Agwld/gps-firmware/gps-mainboard.pdf

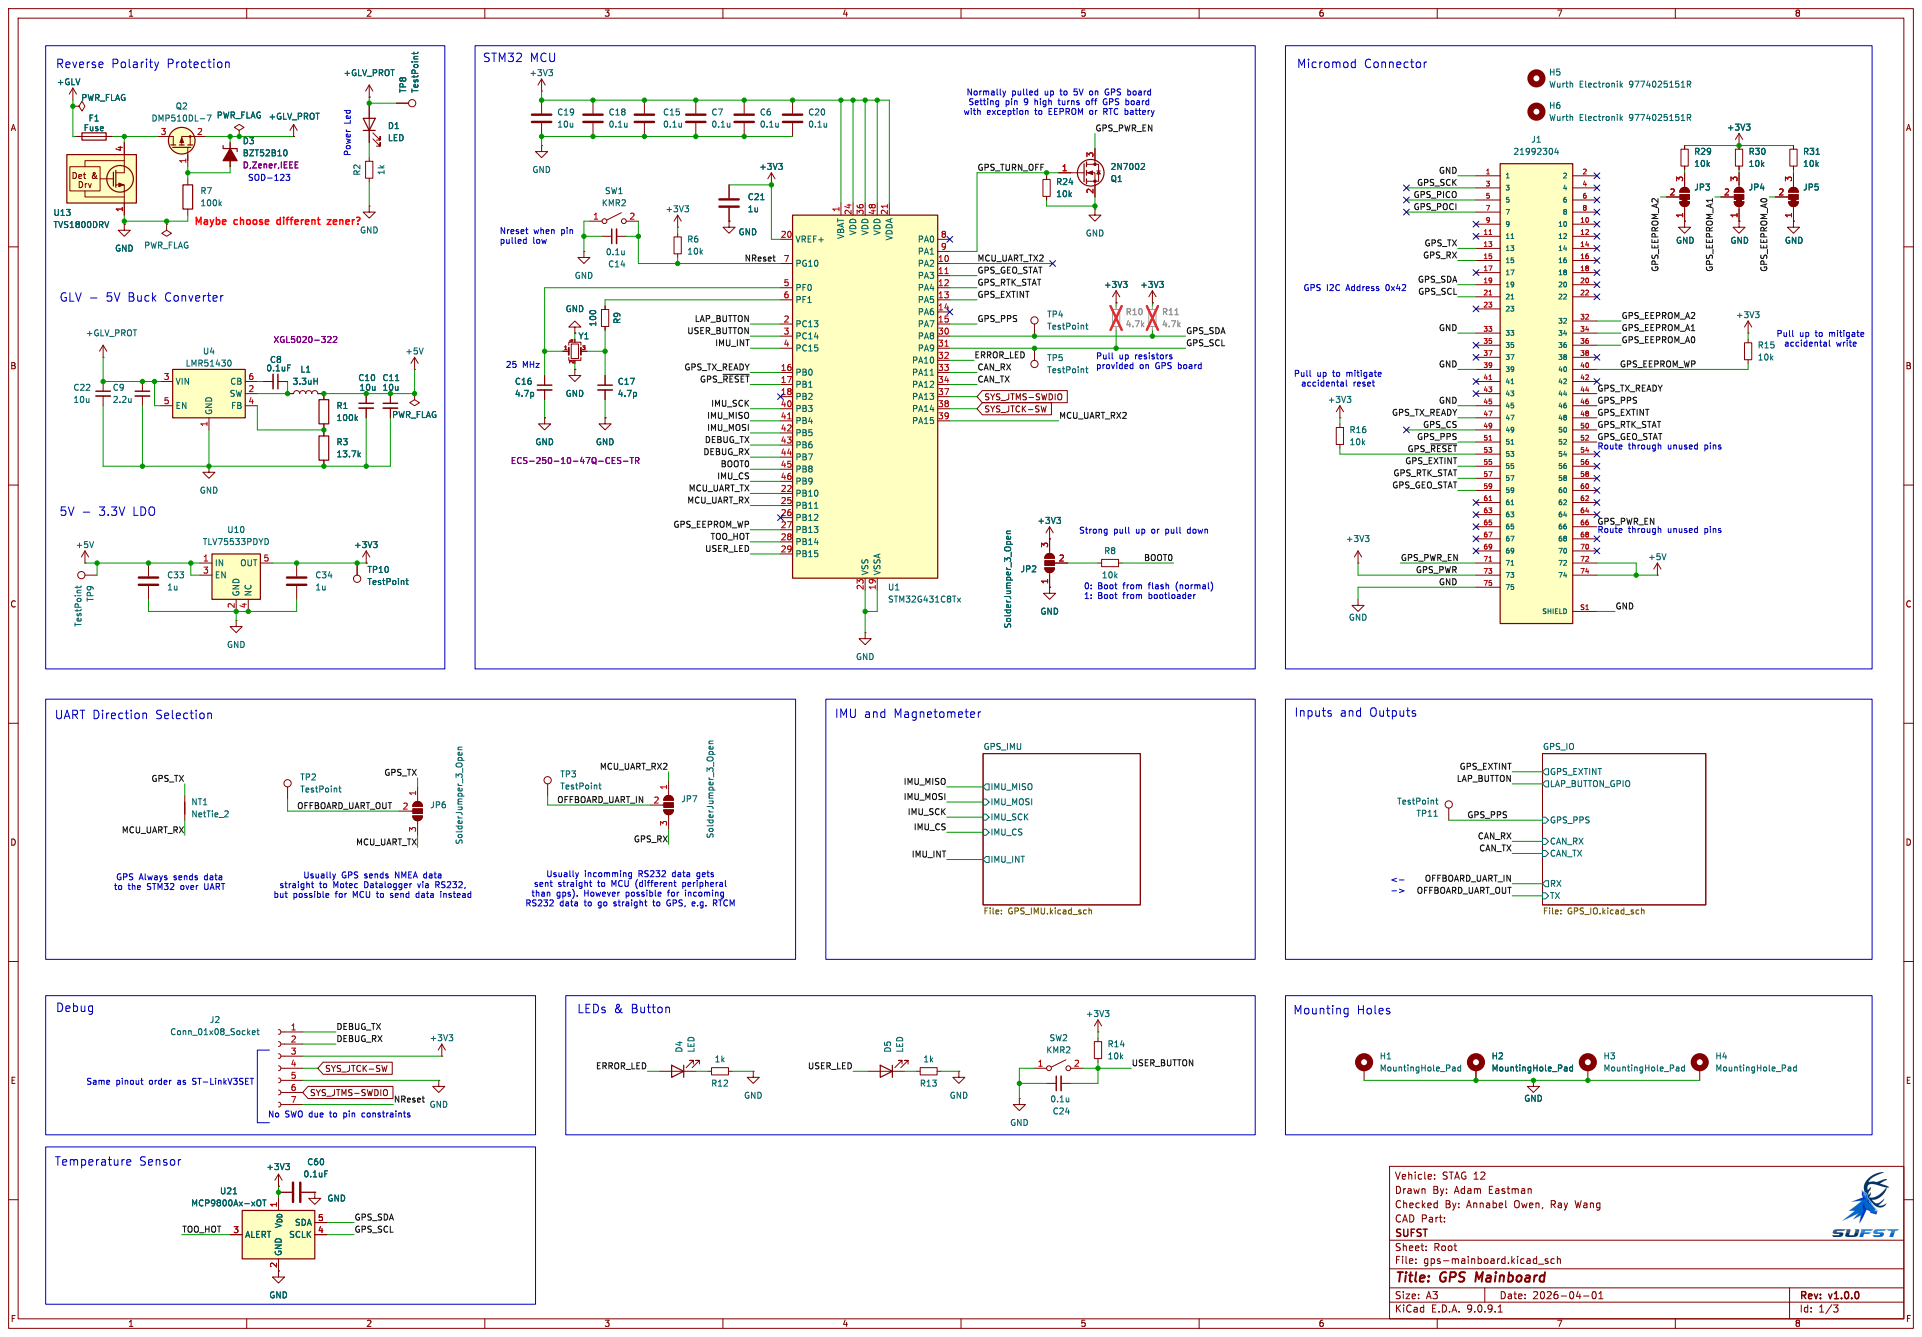
[picture p1: page 1]

Pull up resistors provided on GPS board Reverse Polarity Protection

JP3 GND
10k NT1 NetTie_2
0: Boot from flash (normal) 1: Boot from bootloader Maybe choose different zener?

1 VDD 24 VDD 36 VSS 23 VDD 48 VSSA 19 VDDA 21 PA0 8 PA1 9 PA2 10 PA3 11 PA4 12 PA5 13 PA6 14 PA7 15 PA8 30 PA9 31 PA10 32 PA11 33 PA12 34 PA13 37 PA14 38 PA15 39 U1STM32G431C8Tx

Pull up to mitigate

3Y1 ECS-250-10-47Q-CES-TR GND

1k TP3 TestPoint SDA 5 SCLK 4 V_{DD} 1 GND

GPS Always sends data
to the STM32 over UART

Usually GPS sends NMEA data

-> No SWO due to pin constraints

Same pinout order as ST-LinkV3SET

Id: 1/3 Title: GPS Mainboard

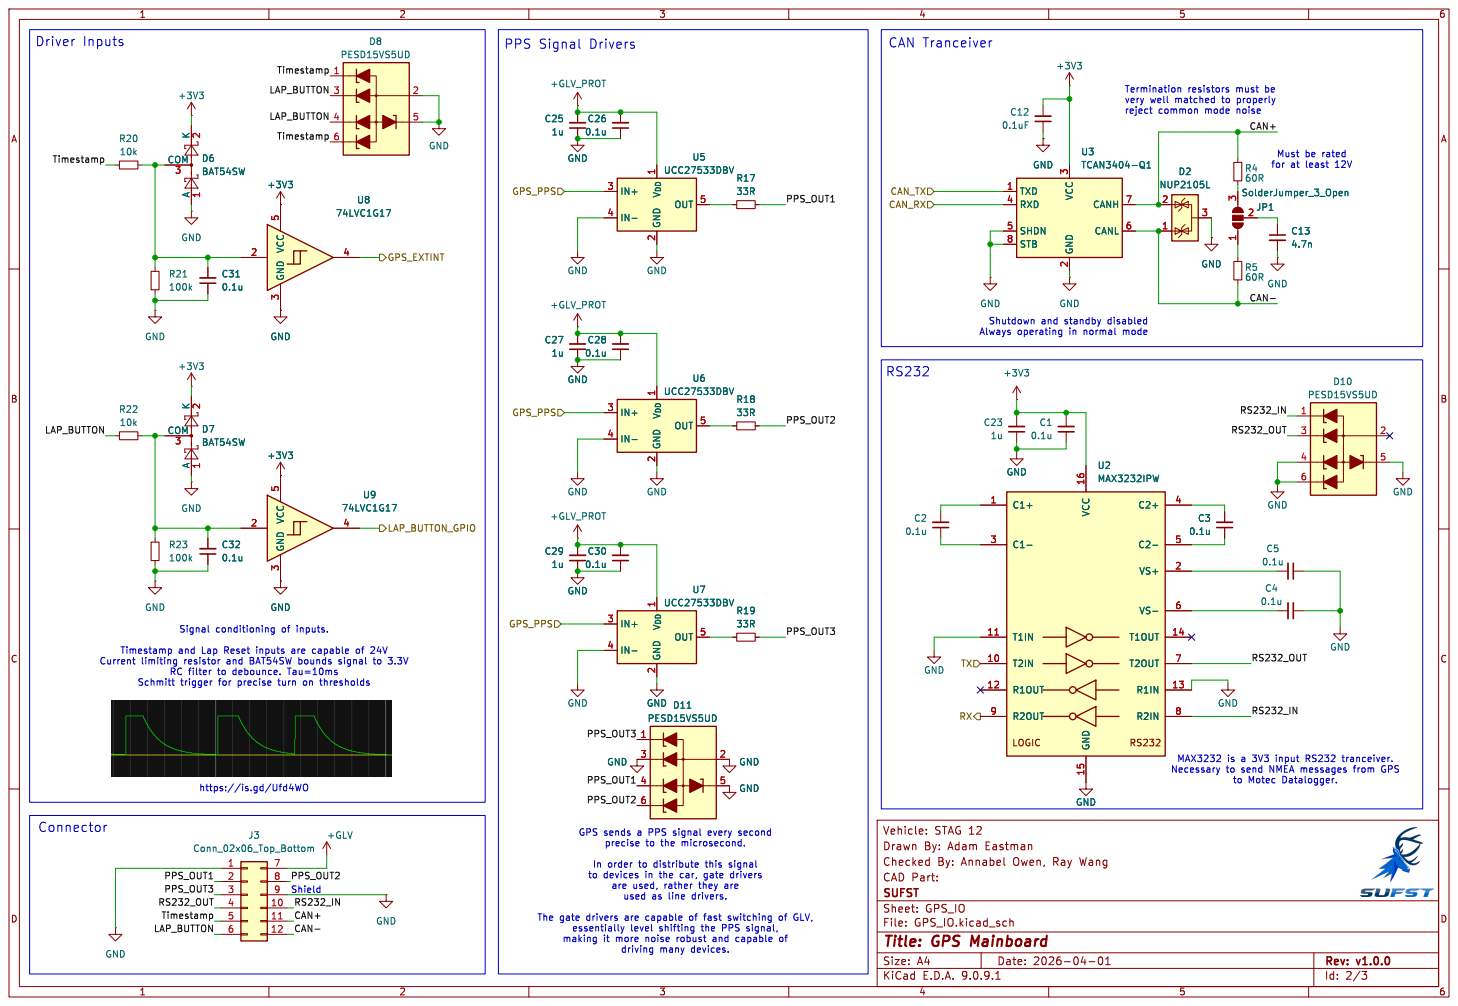
[picture p2: page 2]

reject common mode noise Driver Inputs

for at least 12V MAX3232 is a 3V3 input RS232 tranceiver. Necessary to send NMEA messages from GPS

very well matched to properly

2 CANH 7 CANL 6 U3 TCAN3404-Q1 GND GND GND

2 CANH 7 CANL 6 GND GND

making it more noise robust and capable of driving many devices. Connector

GPS sends a PPS signal every second
precise to the microsecond.

File: GPS_IO.kicad_sch Sheet: GPS_IO
Id: 2/3 Title: GPS Mainboard

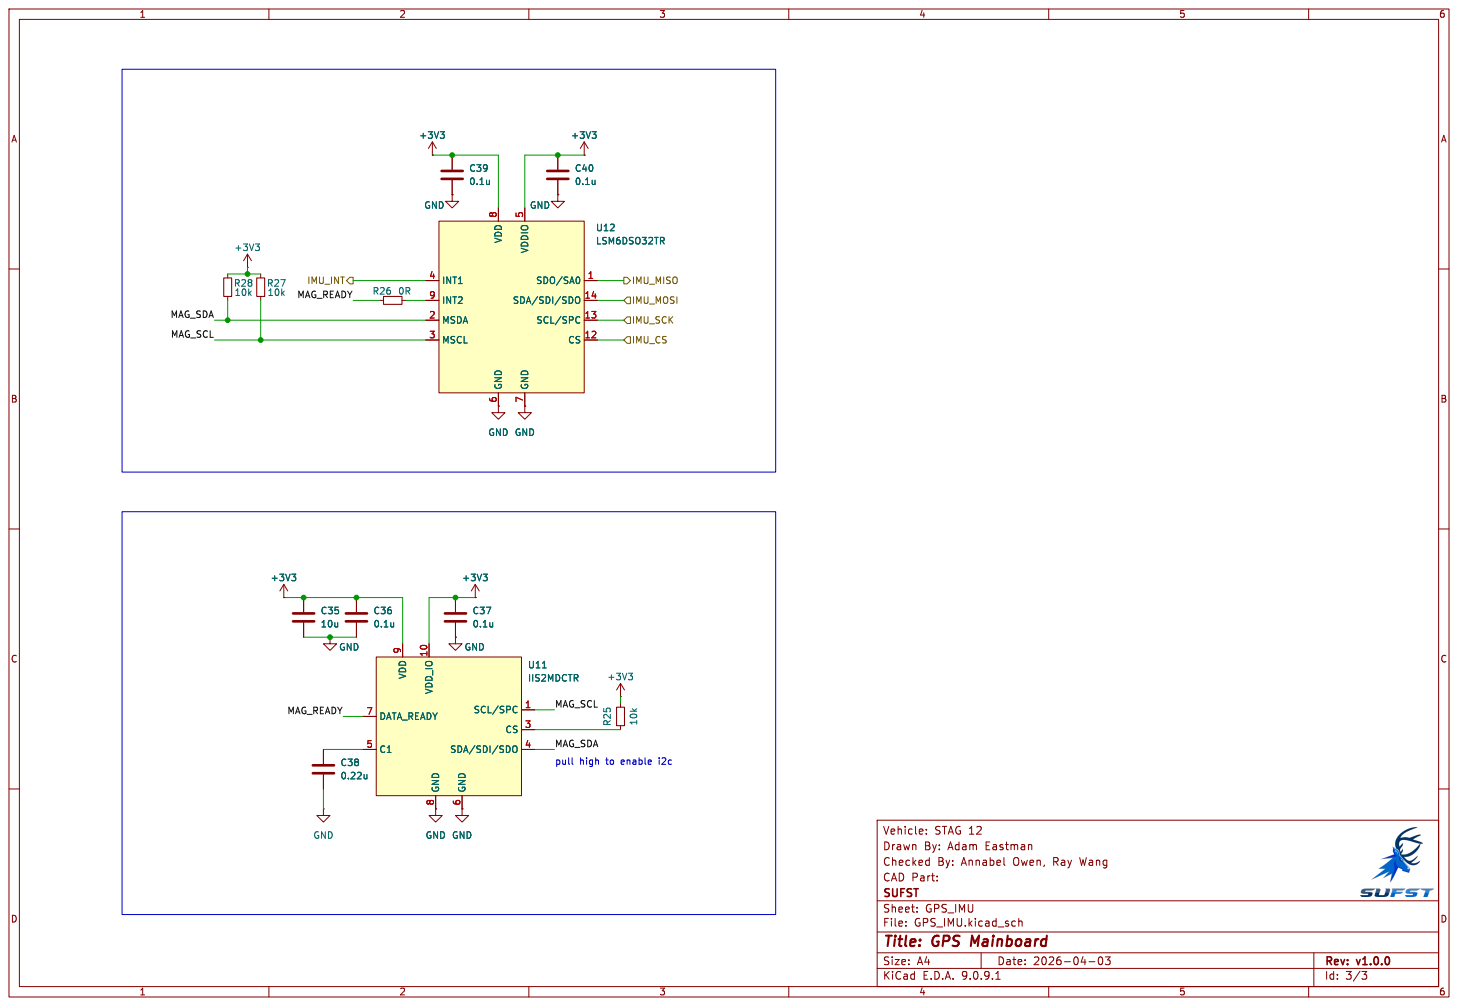
[picture p3: page 3]

7 SDO/SA0 1 SDA/SDI/SDO 14 SCL/SPC 13 CS 12U12

7 SDO/SA0 1 SDA/SDI/SDO 14 SCL/SPC 13 CS 12 GND GND

6 SCL/SPC 1 CS 3 SDA/SDI/SDO 4U11

6 SCL/SPC 1 CS 3 SDA/SDI/SDO 4

pull high to enable i2c

File: GPS_IMU.kicad_sch Sheet: GPS_IMU
Id: 3/3 Title: GPS Mainboard
