Agwld/gps-firmware/Core/Src/spi.c

/**
 * @file    spi.c
 * @brief   SPI1 init for the LSM6DSO32 (mode 3, ~5.3 MHz).
 */

#include "main.h"

SPI_HandleTypeDef hspi1;

void MX_SPI1_Init(void)
{
    hspi1.Instance = SPI1;
    hspi1.Init.Mode = SPI_MODE_MASTER;
    hspi1.Init.Direction = SPI_DIRECTION_2LINES;
    hspi1.Init.DataSize = SPI_DATASIZE_8BIT;
    hspi1.Init.CLKPolarity = SPI_POLARITY_HIGH; /* mode 3 */
    hspi1.Init.CLKPhase = SPI_PHASE_2EDGE;
    hspi1.Init.NSS = SPI_NSS_SOFT;
    /* PCLK2 170 MHz / 32 = 5.3 MHz (LSM6DSO32 max SPI clock is 10 MHz) */
    hspi1.Init.BaudRatePrescaler = SPI_BAUDRATEPRESCALER_32;
    hspi1.Init.FirstBit = SPI_FIRSTBIT_MSB;
    hspi1.Init.TIMode = SPI_TIMODE_DISABLE;
    hspi1.Init.CRCCalculation = SPI_CRCCALCULATION_DISABLE;
    hspi1.Init.CRCPolynomial = 7U;
    hspi1.Init.CRCLength = SPI_CRC_LENGTH_DATASIZE;
    hspi1.Init.NSSPMode = SPI_NSS_PULSE_DISABLE;

    if (HAL_SPI_Init(&hspi1) != HAL_OK) {
        Error_Handler();
    }
}
