Agwld/gps-firmware/SUFST/Inc/sys/sys_task.h

/**
 * @file    sys_task.h
 * @brief   Entry point for sys_task (see app.c for creation).
 */

#ifndef SYS_TASK_H
#define SYS_TASK_H

#ifdef __cplusplus
extern "C" {
#endif

void sys_task_main(void *argument);

#ifdef __cplusplus
}
#endif

#endif /* SYS_TASK_H */
