Agwld/gps-firmware/(commit log)

2026-07-05 fix Wheel_Speeds byte-to-wheel labeling against sufst/can-defs DBC
    The DBC's little-endian start bits put WHEEL_RL_SPEED at byte 0 and
    WHEEL_FR_SPEED at byte 6, but canbc_task.c had the fr/fl/rr/rl
    variables reading those byte offsets in the opposite order. Harmless
    today since the code only sums all four for a symmetric average, but
    would have picked the wrong wheel pair once the planned
    least-slip-prone-pair refinement lands.
    [canbc_task.c]
2026-07-05 add PyQt6 GPS dashboard tool for CAN telemetry visualisation
    Decodes the GPS node's CAN traffic against tools/GPS.dbc: fix/position/
    attitude status, rolling speed/attitude/accel/gyro plots, and a 2D
    track map. Supports live SocketCAN/Vector/Kvaser interfaces, replay of
    candump-format logs, and a synthetic simulate mode, all through the
    same decode/UI pipeline. Also ignores the venv/cache dirs uv and
    pytest generate under tools/dashboard/.
    [base.py, live.py]
2026-07-05 wire up real CPU load reporting via FreeRTOS run-time stats
    GPS_Status.cpu_load_pct was a hardcoded zero because
    configGENERATE_RUN_TIME_STATS was never enabled. Rather than dedicate
    a spare timer to it, reuse the microsecond tick TIM3 already
    free-runs for GPS PPS timing (fusion/timebase.c) as the run-time-stats
    clock - its ~71 min software-extended wrap period comfortably outlasts
    a race session. sys_task.c now reports 100 -
    ulTaskGetIdleRunTimePercent() each cycle.
2026-07-05 convert IMU SPI reads to DMA, yielding the CPU during transfers
    lsm6dso32.c's register reads were blocking HAL_SPI_Transmit/Receive
    calls that spun the imu_task for the ~23us each burst takes. Switch
    read_regs() to a single full-duplex HAL_SPI_TransmitReceive_DMA on the
    SPI1 RX/TX DMA channels (already wired in the MSP but unused) and have
    the caller block on a completion semaphore instead, freeing the CPU
    for other tasks while the transfer runs.
    - Completion/error are signalled from HAL_SPI_TxRxCplt/ErrorCallback,
    which raise CS and give the semaphore; a new SPI1_IRQHandler routes
    bus errors so a fault is reported promptly rather than only via the
    caller's timeout.
    - On timeout, abor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
    [imu_task.c, lsm6dso32.c]
2026-07-05 persist gates as absolute lat/lon; broadcast origin+gates for the dash
    Gate persistence was effectively dead: flash_store_save_gate() was never
    called, and gates were stored as ENU relative to a per-boot origin, so
    they could never reproduce across a power cycle anyway. Rework it so the
    car can be switched off, moved, and switched on with the start/finish
    and sectors returning to the right physical places:
    - flash_store now stores gates as absolute lat/lon (i32 1e-7 deg, not a
    float32 degree which only carries ~1 m). Restore no longer calls
    gates_set (the ENU origin isn't known at boot) - it fills a RAM table
    that imu_task resolves to ENU once the first fix anchors the frame.
    - Both s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
    [can_defs.h, can_pack.c, canbc.c, canbc_task.c, flash_store.c, imu_task.c]
2026-07-05 dashboard: draw gates/origin, remember track shapes, complex sim track
    - track_map renders the broadcast map: start/finish (green) and sector
    (yellow) gate lines lifted from GPS_Gate's ENU through GPS_Frame_Origin
    back to absolute lat/lon, then projected into the widget's frame so
    they line up with the trail regardless of which origin each side picked.
    - track_memory: remembers each track's outline locally, keyed by a
    fingerprint of the (now reproducible) gate layout. On startup the
    matching track's shape reloads as a faint reference so it isn't blank
    until the first lap; saved on close. This is the recommended split -
    the node owns the small, reproducible gates; the dash owns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
2026-07-05 sim: start/finish on a straight + realistic corner/straight speed profile
    Two realism fixes to the simulated circuit:
    - Reshaped the track so the start/finish sits on a genuine main straight
    (three collinear waypoints keep it dead straight) instead of on the
    tight return it landed on before - no more hairpin across the line.
    - Replaced the constant-speed march with a curvature-derived speed
    profile: grip-limited corner speeds (sqrt(a_lat/kappa)) with
    forward/backward accel+brake passes so the car brakes into and powers
    out of corners, then time-scaled so a lap still takes lap_period_s.
    Longitudinal g (GPS_IMU_Accel ax) now reflects that braking/accel too.
    On the default track s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
    [simulate.py]
2026-07-05 dashboard: remote gate control + working lap timing
    Two gaps the receive-only dashboard had:
    - Remote control: added a TX path (CanSource.send, LiveCanSource.send via
    python-can, IngestWorker.send) and a Gate control panel that mirrors
    the steering-wheel lap button - Set start/finish, Set next sector
    (auto-incrementing slot), Clear all, Save to flash - sending
    GPS_Command frames. Live mode puts them on the real bus; simulate mode
    drives the simulated node.
    - Lap timing: the simulator now runs a real gate-crossing timer instead
    of faking it - it accepts GPS_Command (dynamic 8-slot gate table),
    detects crossings in arc-length space, and emits Lap_Event (lap +
    sector) with a p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
2026-07-05 docs: comprehensive product documentation suite
    Add professional documentation covering all aspects of the GPS node:
    - README.md: Clean product-focused overview (gates, timing, status)
    - QUICK_START.md: 5-minute build guide for engineers
    - DEVELOPER.md: Full development guide (build, test, debug, CI, conventions)
    - DRIVER_GUIDE.md: User guide for drivers (button FSM, troubleshooting)
    - ARCHITECTURE.md: Technical deep dive (fusion, timing, CAN, persistence)
    - DATASHEET.md: Complete hardware & firmware specs (pinouts, memory, matrix)
    - NOTES.md: Design rationale, limitations, future enhancements
    Documentation structured for multiple audiences: drivers, developers, maintainers.
    Co-Authored-B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
2026-07-05 Update PCB size from 2 layers to 4 layers
2026-07-05 Update DATASHEET.md by removing specifications
    Removed mounting and form factor specifications from the datasheet.
2026-07-05 Remove board dimensions and connectors section
    Removed hardware specifications section from DATASHEET.md.
2026-07-05 canbus: broadcast GPS time on 0x6BD for other nodes
    New 1 Hz GPS_Time message: iTOW (same time domain as Lap_Event TM2
    marks, so other boards can timestamp their data consistently) plus UTC
    hour/min/sec for a human clock, with NAV-PVT validity flags. UTC date
    is deliberately not carried - it doesn't fit alongside full-precision
    iTOW in 8 bytes, and the MoTeC already gets it via NMEA RMC.
    Published from gps_task on every NAV-PVT (even before a position fix -
    time can resolve from fewer satellites, and the flags say how much to
    trust it). Dashboard status panel shows the UTC clock + iTOW readouts.
    [can_defs.h, can_pack.c, canbc.c, canbc_task.c, gps_task.c, test_can_pack.c]
2026-07-05 gps: configure the F9P over I2C - the board has no MCU->GPS UART path
    Verifying the firmware against the gps-mainboard schematic's UART
    direction jumpers showed three routing mismatches:
    - gps_config sent UBX-CFG-VALSET out USART3 TX, but PB10 only reaches
    the RS232 output via JP6; the F9P's UART1 RX is only fed from the
    RS232 input via JP7. Config could never arrive: the GPS would stay at
    its 38400/NMEA power-on defaults and the node would boot straight
    into GPS_FAULT on real hardware.
    - NMEA to the MoTeC went out USART2 TX (PA2), which is unrouted on the
    board.
    - The RTCM bridge forwarded USART2 RX to USART3 TX, which now feeds the
    MoTeC, not the GPS.
    New arrangement (jumpers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
2026-07-06 docs: fix aux_task role in DEVELOPER task table
    Straggler from af3be50: aux_task no longer forwards RTCM (that path is
    now RS232-in -> F9P UART1 in hardware via JP7, never touching the MCU).
    It only synthesises NMEA to the MoTeC on USART3 TX.
2026-07-06 imu: place gates stationary + continuous self-calibrating magnetometer
    Two related heading changes so gates/start-line can be set from a
    standstill, not only while driving.
    Gate placement: the gate line was always oriented from course-over-
    ground (the velocity vector), which is noise at rest - so a stationary
    set produced a randomly-rotated gate. Now hybrid: course when moving
    (>= LAP_GATE_COURSE_MIN_SPEED_MPS, mag-independent), else the AHRS yaw,
    which is valid stationary. Park nose-down-track, set, done.
    Magnetometer calibration: replaced the manual CAN-triggered min/max pass
    with continuous background calibration (mag_cal_cont_*). Every sample
    feeds a rolling window that tracks heading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
    [board_config.h, imu_task.c, mag_cal.c, test_mag_cal.c]
2026-07-06 build: require STM32G431CB, drop the C8 variant
    The board is built around the CB (128 KB flash); the smaller C8 (64 KB)
    was only ever kept selectable for interchangeability testing and Debug
    builds never fit it. Remove the whole variant machinery: delete
    STM32G431X8_FLASH.ld and the GPS_MCU_VARIANT switch, hardcode the CB
    linker script + GPS_FLASH_TOTAL_KB=128 (still the single source the
    flash-store reserved page derives from, so it can't drift from the
    linker script). Docs now state CB as a requirement.
    Also corrected the gate-store address in DATASHEET (0x1FC00 -> the
    actual 0x0801F800: last 2 KB page of 128 KB), which disagreed with
    ARCHITECTURE.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
    [flash_store.c]
2026-07-08 fix: resolve whole-project code review findings
    Fifteen correctness/robustness fixes from a full-codebase review, outside
    the continuous-mag-cal change.
    GPS / UBX:
    - gps_task: reduce the DMA ring write index modulo the ring size - a
    512-byte buffer wrap reports Size==512, which spun the drain loop
    forever and hung the task until the watchdog reset the node
    - gps_task: gate the PPS time-lock on NAV-PVT VALID_TIME so the timebase
    can't lock to an unresolved GPS second
    - gps_task: TM2 edge dedup uses a seen-flag instead of a 0xFFFF sentinel
    that collides with a real edge counter value
    - gps_config: yield every poll iteration during boot so a busy DDC
    stream can't starve the watchdog-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
    [app.c, board_config.h, can_pack.c, canbc_task.c, geodesy.c, gps_config.c, gps_task.c, imu_task.c]
